Red-Singularity/Capacitor-Clock/Capacitor-Clock-PCB/Capacitor-Clock-PCB.kicad_pcb

## KiCad design Capacitor-Clock-PCB/Capacitor-Clock-PCB.kicad_pcb (2026-03-11)

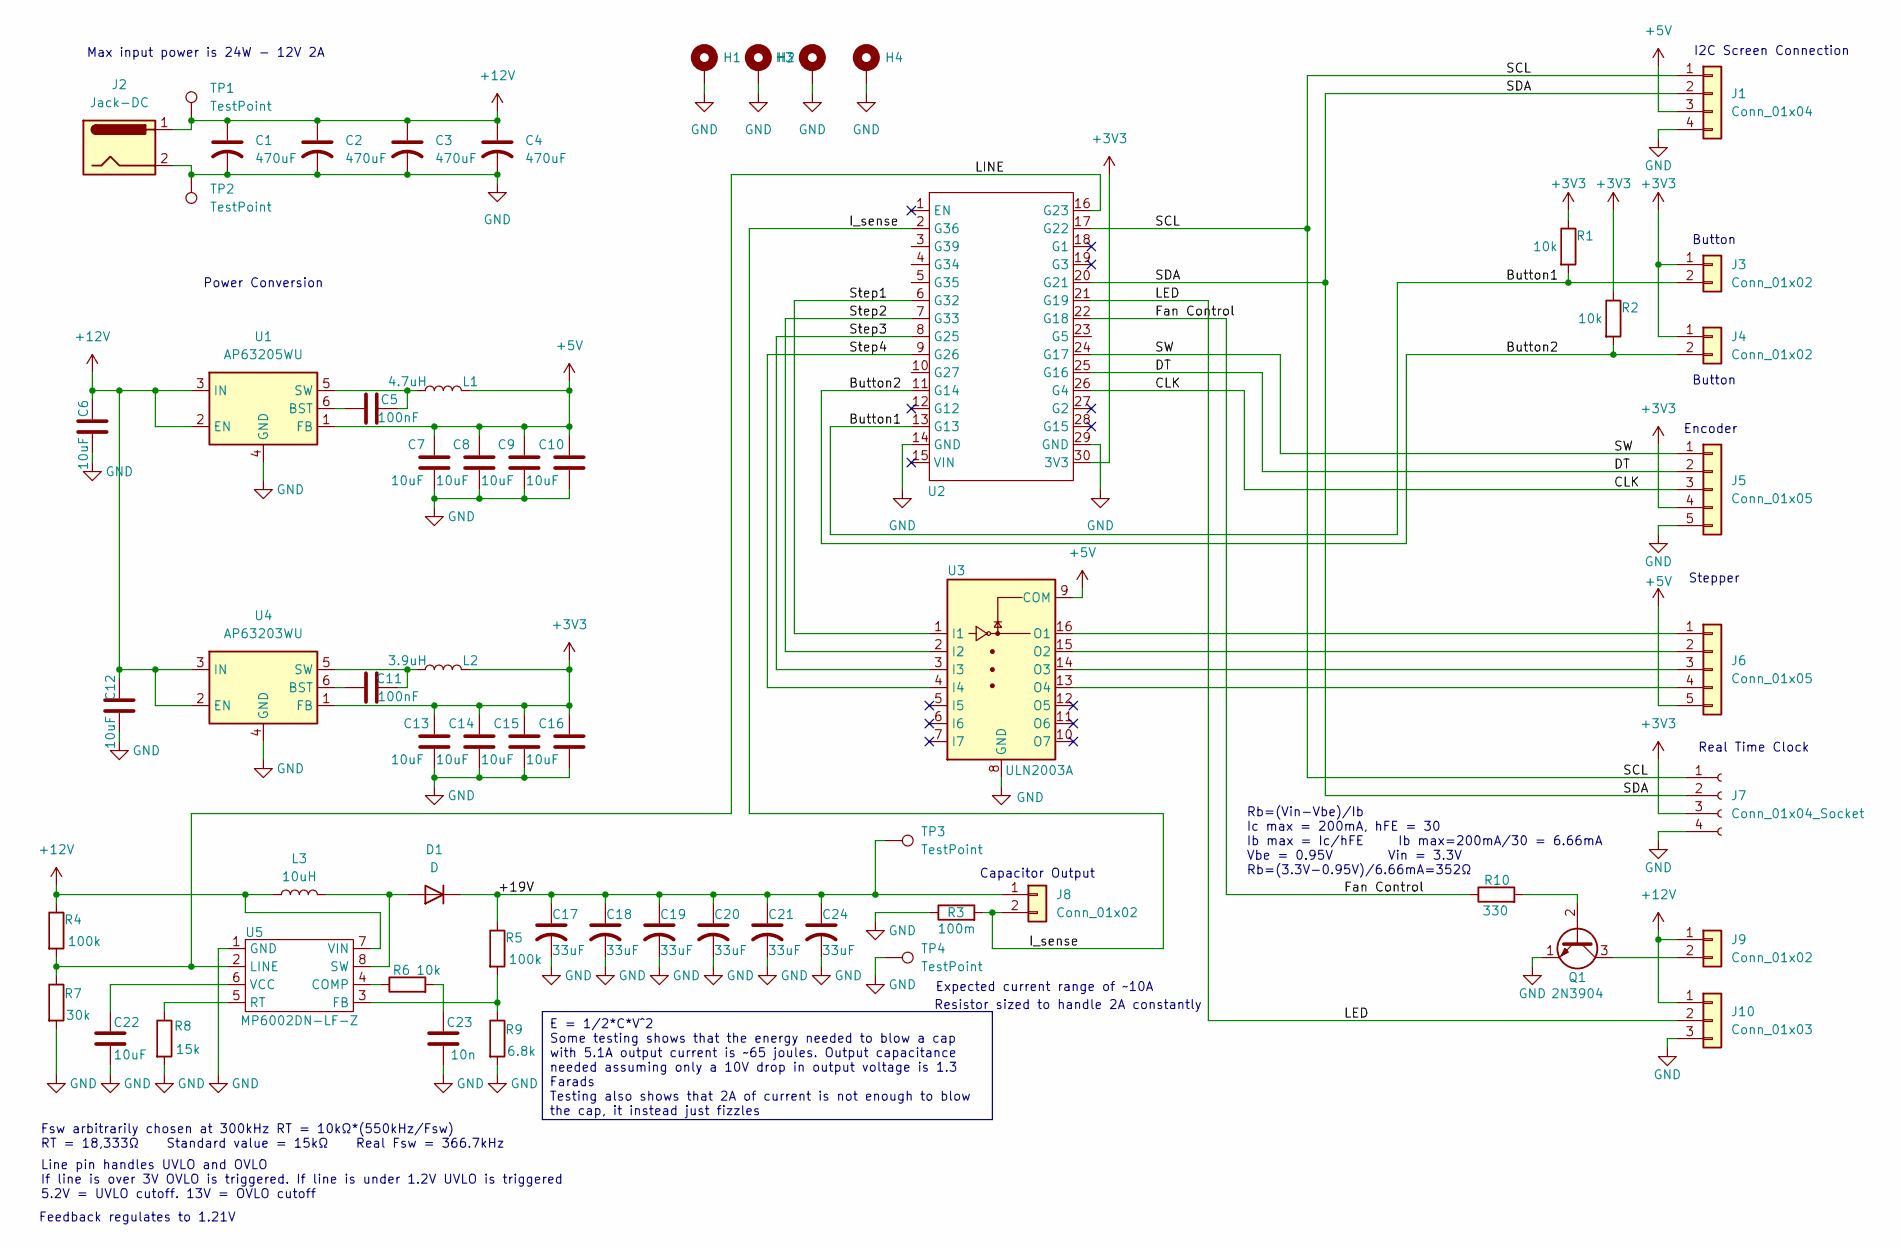
[picture p1: schematic Capacitor-Clock-PCB.kicad_sch]

Parts:
C1, C2, C3, C4: 470uF; CP_Radial_Tantal_D8.0mm_P2.50mm
C5, C11: 100nF; C_Disc_D5.1mm_W3.2mm_P5.00mm
C6, C7, C8, C9, C10, C12, C13, C14, C15, C16, C22: 10uF; C_Disc_D5.1mm_W3.2mm_P5.00mm
C17, C18, C19, C20, C21, C24: 33uF; CP_Radial_Tantal_D5.0mm_P2.50mm
C23: 10n; C_Disc_D5.1mm_W3.2mm_P5.00mm
D1: D; D_A-405_P7.62mm_Horizontal
H1, H2, H3, H4: MountingHole_Pad; MountingHole_3.2mm_M3_DIN965_Pad
J1: Conn_01x04; JST_XH_B4B-XH-A_1x04_P2.50mm_Vertical
J2: Jack-DC; BarrelJack_CUI_PJ-063AH_Horizontal
J3, J4, J9: Conn_01x02; JST_XH_B2B-XH-A_1x02_P2.50mm_Vertical
J5, J6: Conn_01x05; JST_XH_B5B-XH-A_1x05_P2.50mm_Vertical
J7: Conn_01x04_Socket; PinSocket_1x04_P2.54mm_Vertical
J8: Conn_01x02; PinSocket_1x02_P2.54mm_Vertical
J10: Conn_01x03; JST_XH_B3B-XH-A_1x03_P2.50mm_Vertical
L1: 4.7uH; IND_SRR4818A-3R3Y
L2: 3.9uH; IND_SRR4818A-3R3Y
L3: 10uH; L_Radial_D8.7mm_P5.00mm_Fastron_07HCP
Q1: 2N3904; TO-92_Inline
R1, R2, R6: 10k; R_Axial_DIN0207_L6.3mm_D2.5mm_P7.62mm_Horizontal
R3: 100m; R_2512_6332Metric
R4, R5: 100k; R_Axial_DIN0207_L6.3mm_D2.5mm_P7.62mm_Horizontal
R7: 30k; R_Axial_DIN0207_L6.3mm_D2.5mm_P7.62mm_Horizontal
R8: 15k; R_Axial_DIN0207_L6.3mm_D2.5mm_P7.62mm_Horizontal
R9: 6.8k; R_Axial_DIN0207_L6.3mm_D2.5mm_P7.62mm_Horizontal
R10: 330; R_Axial_DIN0207_L6.3mm_D2.5mm_P7.62mm_Horizontal
TP1, TP2, TP3, TP4: TestPoint
U1: AP63205WU; TSOT-23-6
U2: MODULE_ESP32_DEVKIT_V1
U3: ULN2003A; DIP-16_W7.62mm
U4: AP63203WU; TSOT-23-6
U5: MP6002DN-LF-Z; SOIC-8-1EP_3.9x4.9mm_P1.27mm_EP2.41x3.3mm

Connections:
+3V3: C13.2, C14.2, C15.2, C16.2, J3.1, J4.1, J5.4, J7.3, L2.2, R1.1, R2.1, U2.30 (3V3), U4.1 (FB)
+5V: C7.2, C8.2, C9.2, C10.2, J1.3, J6.5, L1.2, U1.1 (FB), U3.9 (COM)
+12V: C1.1, C2.1, C3.1, C4.1, C6.2, C12.2, J2.1, J9.1, J10.1, L3.1, R4.1, TP1.1, U1.2 (EN), U1.3 (IN), U4.2 (EN), U4.3 (IN), U5.7 (VIN)
/+19V: C17.1, C18.1, C19.1, C20.1, C21.1, C24.1, D1.1 (K), J8.1, R5.1, TP3.1
/Button1: J3.2, R1.2, U2.13 (G13)
/Button2: J4.2, R2.2, U2.11 (G14)
/CLK: J5.3, U2.26 (G4)
/DT: J5.2, U2.25 (G16)
/Fan Control: R10.1, U2.22 (G18)
/I_sense: J8.2, R3.2, U2.2 (G36)
/LED: J10.2, U2.21 (G19)
/LINE: R4.2, R7.1, U2.16 (G23), U5.2 (LINE)
/SCL: J1.1, J7.1, U2.17 (G22)
/SDA: J1.2, J7.2, U2.20 (G21)
/SW: J5.1, U2.24 (G17)
/Step1: U2.6 (G32), U3.1 (I1)
/Step2: U2.7 (G33), U3.2 (I2)
/Step3: U2.8 (G25), U3.3 (I3)
/Step4: U2.9 (G26), U3.4 (I4)
GND: C1.2, C2.2, C3.2, C4.2, C6.1, C7.1, C8.1, C9.1, C10.1, C12.1, C13.1, C14.1, C15.1, C16.1, C17.2, C18.2, C19.2, C20.2, C21.2, C22.1, C23.1, C24.2, H1.1, H2.1, H3.1, H4.1, J1.4, J2.2, J5.5, J7.4, J10.3, Q1.1 (E), R3.1, R7.2, R8.2, R9.2, TP2.1, TP4.1, U1.4 (GND), U2.14 (GND), U2.29 (GND), U3.8 (GND), U4.4 (GND), U5.1 (GND)
unnamed: C23.2, R6.2
unnamed: D1.2 (A), L3.2, U5.8 (SW)
unnamed: J6.1, U3.16 (O1)
unnamed: J6.2, U3.15 (O2)
unnamed: J6.3, U3.14 (O3)
unnamed: J6.4, U3.13 (O4)
unnamed: J9.2, Q1.3 (C)
unnamed: Q1.2 (B), R10.2
unnamed: C5.1, U1.6 (BST)
unnamed: C5.2, L1.1, U1.5 (SW)
unnamed: C11.1, U4.6 (BST)
unnamed: C11.2, L2.1, U4.5 (SW)
unnamed: R6.1, U5.4 (COMP)
unnamed: R5.2, R9.1, U5.3 (FB)
unnamed: R8.1, U5.5 (RT)
unnamed: C22.2, U5.6 (VCC)

Notes on the sheet:
Button
Expected current range of ~10A
Fsw arbitrarily chosen at 300kHz RT = 10kΩ*(550kHz/Fsw) RT = 18,333Ω Standard value = 15kΩ Real Fsw = 366.7kHz
I2C Screen Connection
Capacitor Output
Max input power is 24W - 12V 2A
Resistor sized to handle 2A constantly
Feedback regulates to 1.21V
Rb=(Vin-Vbe)/Ib Ic max = 200mA, hFE = 30 Ib max = Ic/hFE Ib max=200mA/30 = 6.66mA Vbe = 0.95V Vin = 3.3V Rb=(3.3V-0.95V)/6.66mA=352Ω
Encoder
Real Time Clock
Stepper
Line pin handles UVLO and OVLO If line is over 3V OVLO is triggered. If line is under 1.2V UVLO is triggered 5.2V = UVLO cutoff. 13V = OVLO cutoff
Power Conversion
E = 1/2*C*V^2 Some testing shows that the energy needed to blow a cap with 5.1A output current is ~65 joules. Output capacitance needed assuming only a 10V drop in output voltage is 1.3 Farads Testing also shows that 2A of current is not enough to blow the cap, it instead just fizzles

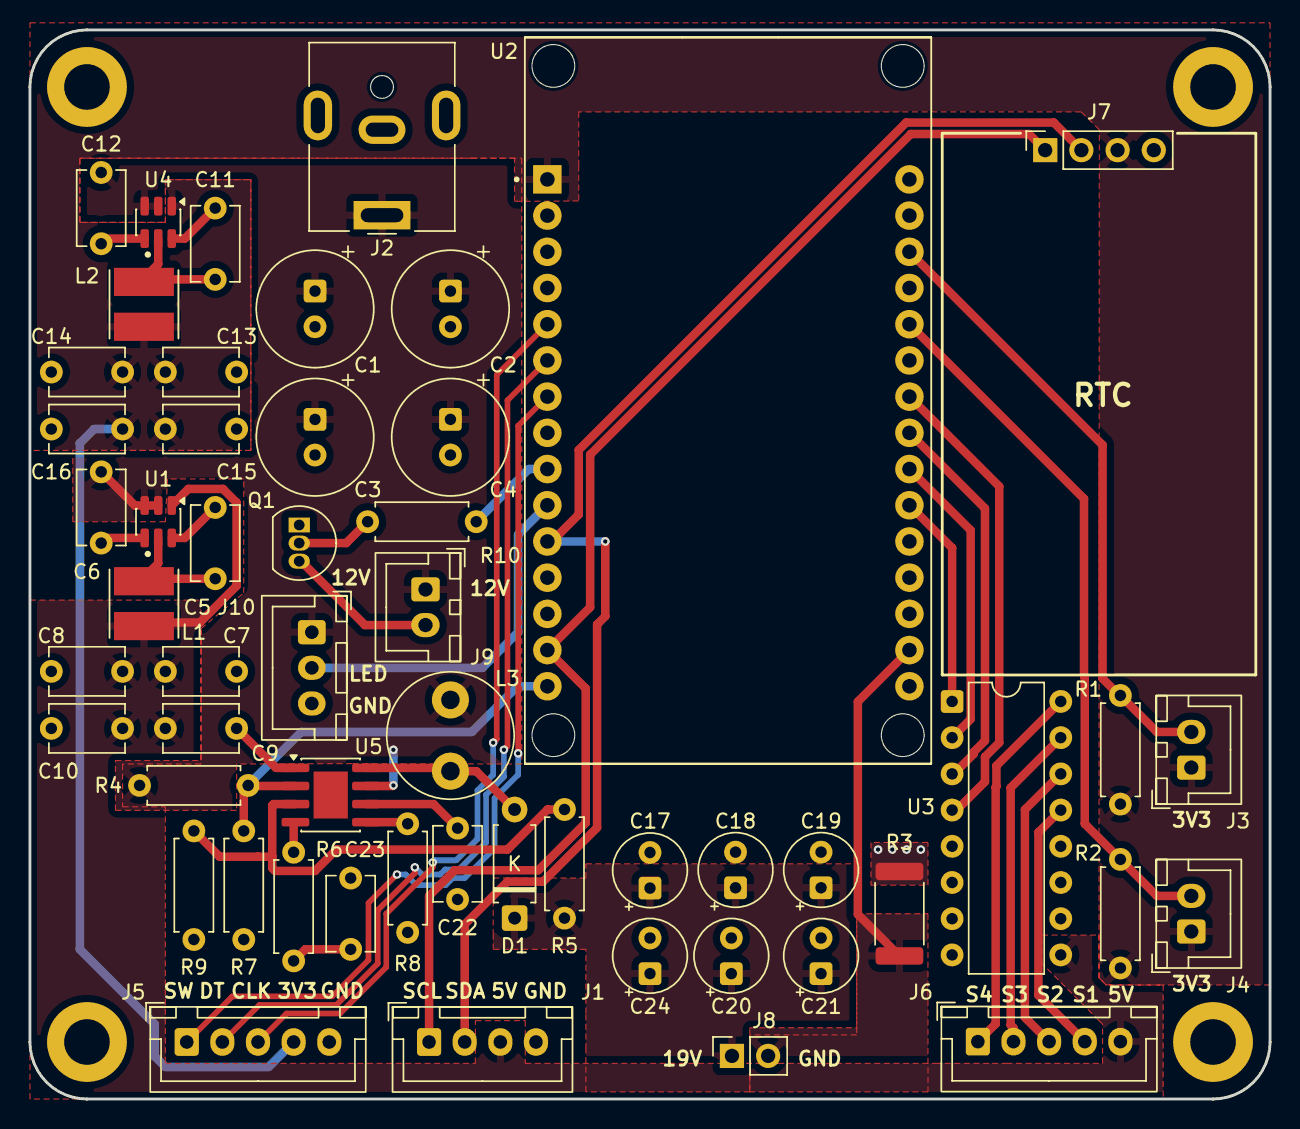
[picture p2: board Capacitor-Clock-PCB.kicad_pcb from above]

Board: 2 copper layers, 87.0 x 75.0 mm, 58 parts (0 on the bottom side), 36 nets.
