Red-Singularity/Capacitor-Clock/(commit log)

2026-02-25 adjusted code to display to lcd
    began filling out code and was able to make code that displayed to a 2x16 display that can display the general GUI
    [Capacitor-Clock-PCB.kicad_pcb, Capacitor-Clock-PCB.kicad_sch]
2026-03-09 Preliminary Schematic Finished
    Finished the schematic for the clock and is ready for review. going to continue to pcb layout in meantime
    [Capacitor-Clock-PCB.kicad_sch]
2026-03-09 picked induictor and diode
    [Capacitor-Clock-PCB.kicad_sch]
2026-03-09 board component placement
    finished preliminary component placement. ready for routing
    [Capacitor-Clock-PCB.kicad_pcb, Capacitor-Clock-PCB.kicad_sch]
2026-03-09 finished preliminary routing
    finished routing ready for review
    [Capacitor-Clock-PCB.kicad_pcb, Capacitor-Clock-PCB.kicad_sch]
2026-03-11 Update post design review
    updated schematic and pcb with notes from review. added switchable fan header, ability to control output prongs, and RGB header
    [Capacitor-Clock-PCB.kicad_pcb, Capacitor-Clock-PCB.kicad_sch]
2026-03-11 PCB ordered
    Ordered PCB
    [Capacitor-Clock-PCB-B_Cu.gbr, Capacitor-Clock-PCB-B_Mask.gbr, Capacitor-Clock-PCB-B_Paste.gbr, Capacitor-Clock-PCB-B_Silkscreen.gbr, Capacitor-Clock-PCB-Edge_Cuts.gbr, Capacitor-Clock-PCB-F_Cu.gbr, Capacitor-Clock-PCB-F_Mask.gbr, Capacitor-Clock-PCB-F_Paste.gbr]
2026-03-20 encoder and cursor
2026-03-21 working time adjust
    got time adjustment with encoder to work
2026-03-23 post 6am sprint
    got all clock functions and UI elements working. made basic stepper control as a result
